shimniok/avrcam/Electronics/BOM.ods

 |  | Notes |  |  | Notes
C1 | 0.1uF |  | R1 | 10K
C2 | 0.1uF | ?? | R2 | 1K
C3 | 0.1uF | ?? | R3 | 1K
C4 | 0.1uF |  | R4 | 1K
C5 | 10uF |  | R5 | 10K
C6 | 0.1uF |  | R6 | 10K
C7 | 1uF | opt | R7 | 10K
C8 | 1uF | opt | R8 | 10K
C9 |  |  | R9 | 10K
C10 | 0.1uF
C11 |  |  | JP1
C12 |  |  | JP2 | 0.1 pin hd | opt
C13 | 1uF | opt | JP3
C14 |  |  | JP4
C15 | 1uF | opt
C16 |  |  | T1 | 2N3904
C17
C18
IC1 | Atmega8-P
IC2 | Attiny12
IC3
IC4
IC5 | LM2937
