shimniok/avrcam/(list of files, cad)

Other CAD files:
Tiny13/AVRCamTiny.obj
