shimniok/avrcam/Electronics/AVRcam.pdf

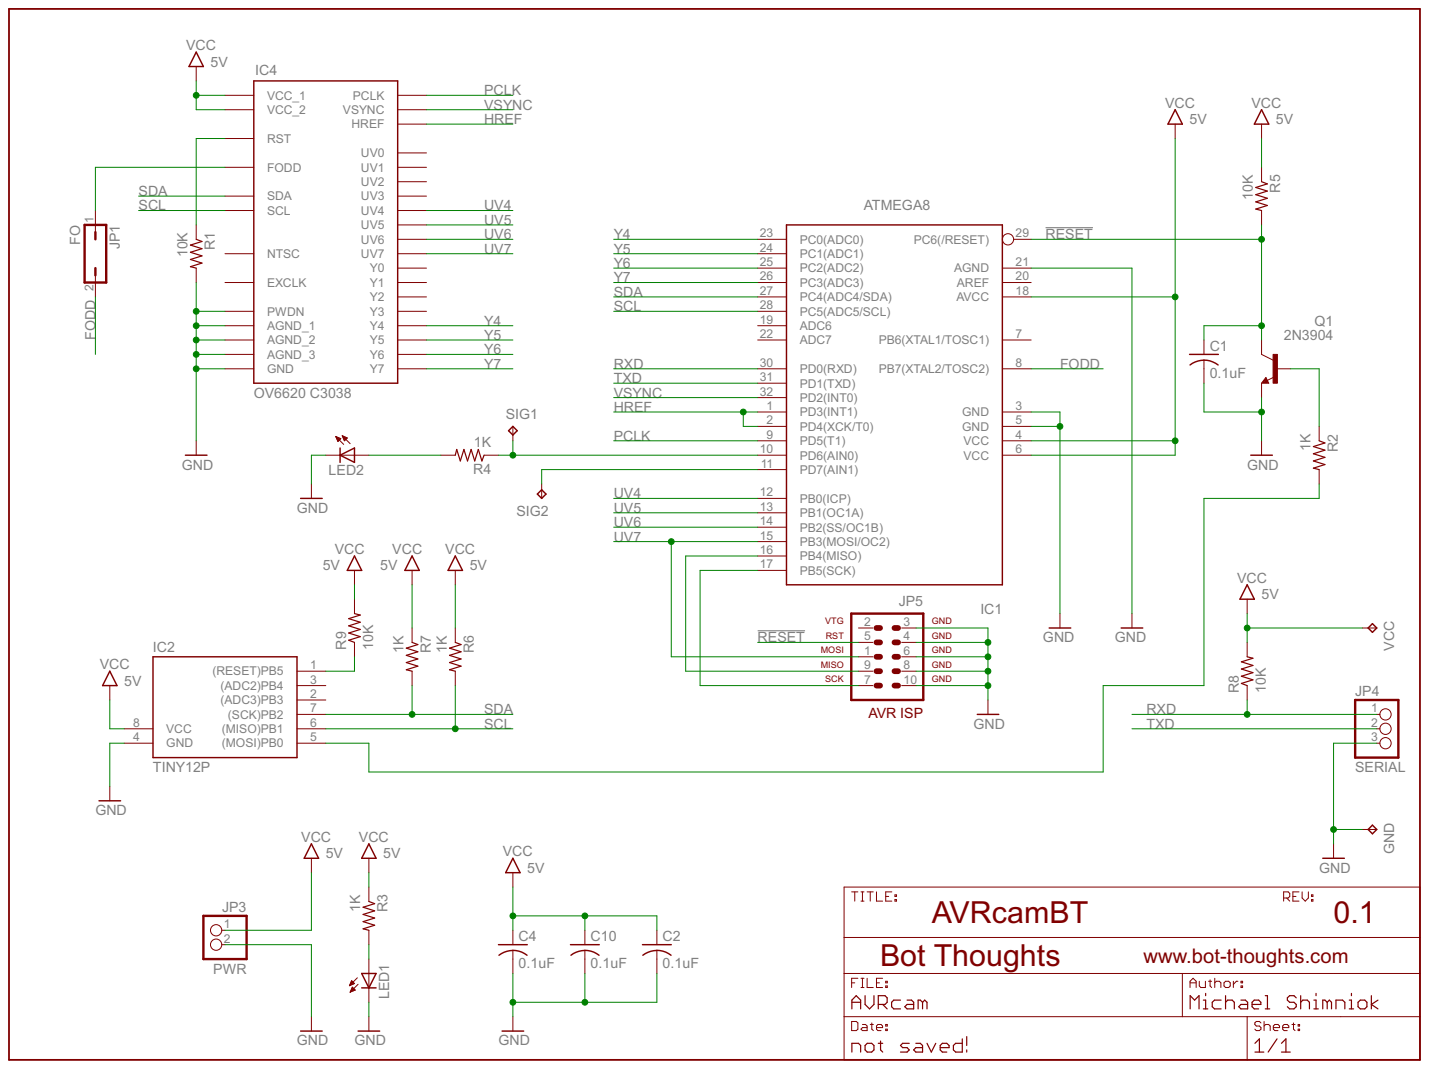
[picture p1: page 1]
