shimniok/avrcam/Electronics/AVRcam_sch.pdf

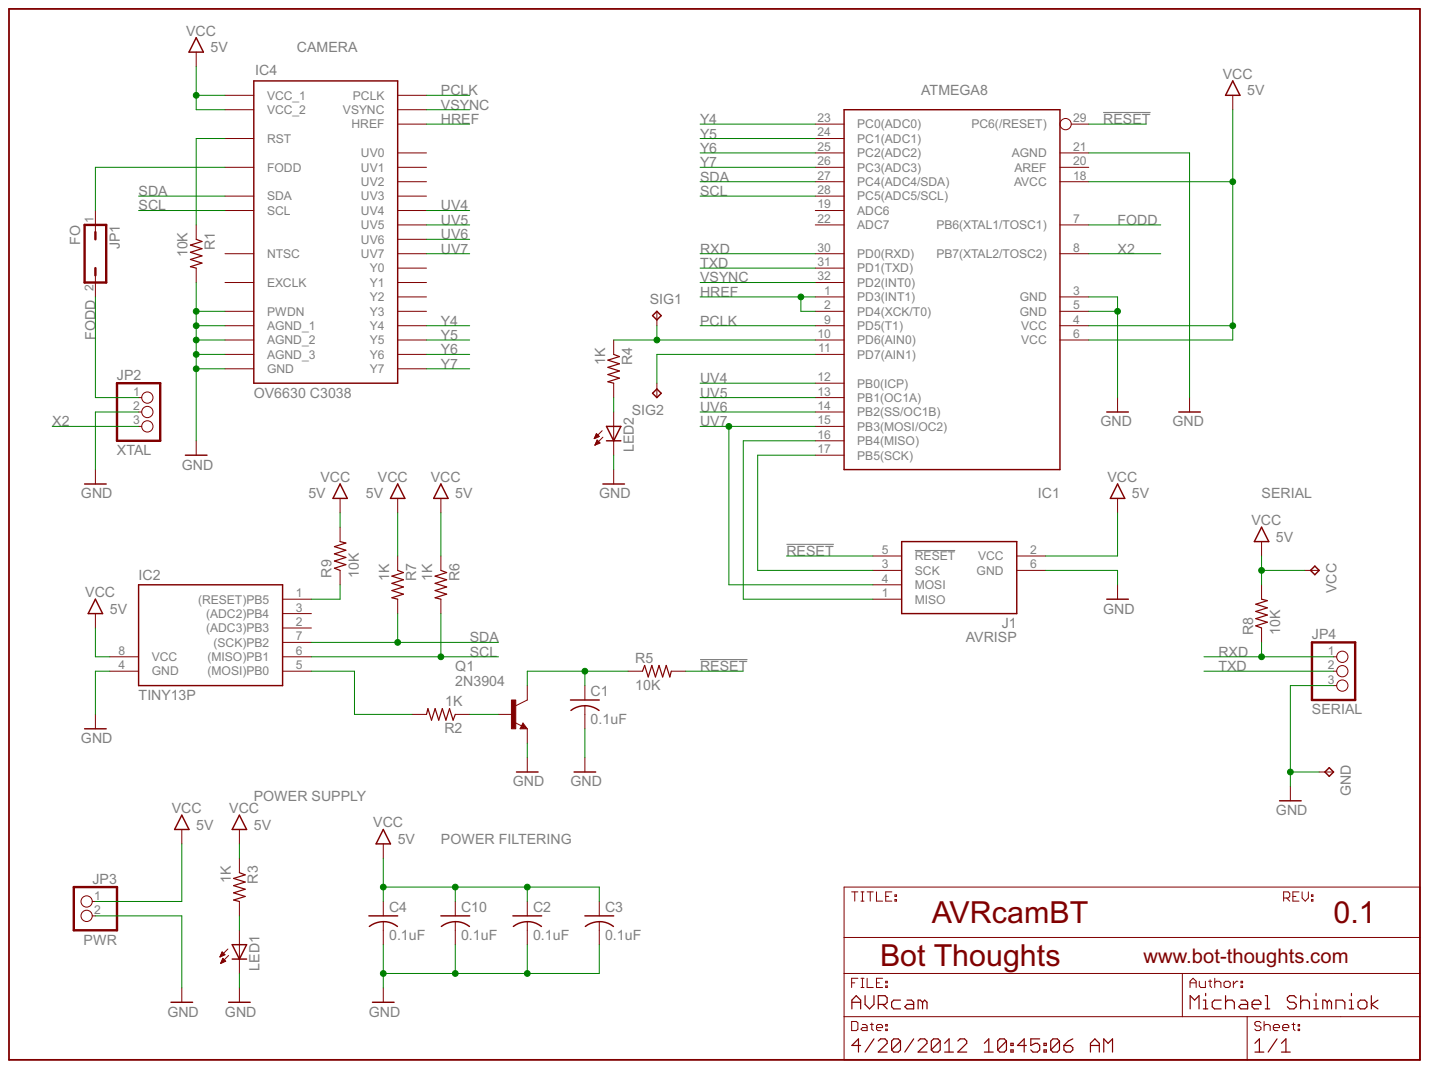
[picture p2: page 1]
