shimniok/avrcam/Electronics/AVRcam.brd

## EAGLE design Electronics/AVRcam.brd (2012-05-16)

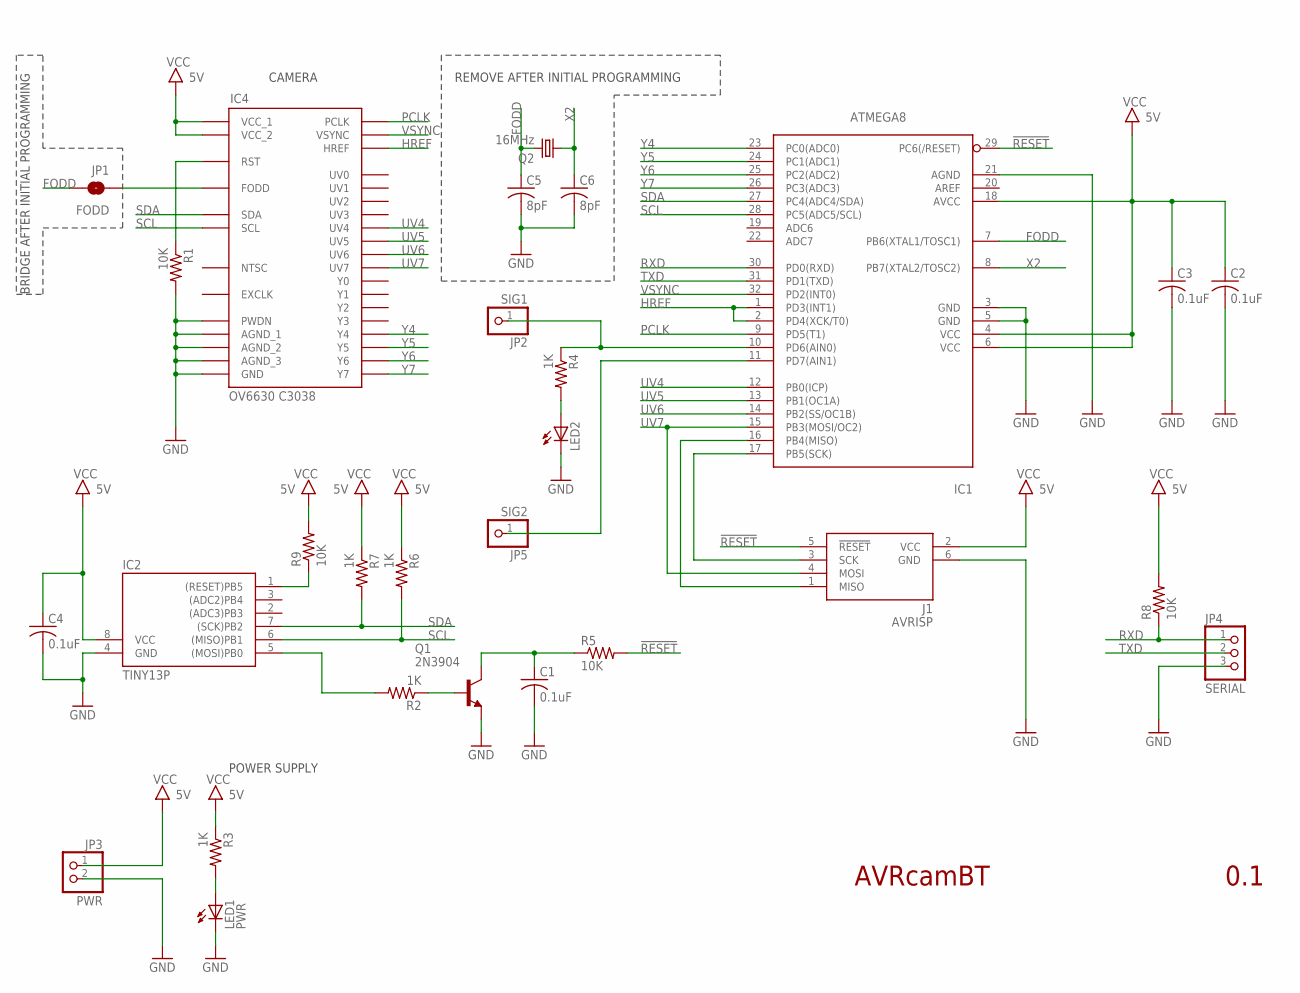
[picture p3: schematic AVRcam.sch]

Parts:
C1, C2, C3, C4: 0.1uF; C0603; PARTNO CC0603ZRY5V9BB104
C5, C6: 8pF; C0603; PARTNO C1608C0G1H080D
IC1: ATMEGA8; TQFP32-08; PARTNO ATMEGA8A-AU
IC2: TINY13P; DIL08; PARTNO ATTINY13V-10PU
IC4: OV6630 C3038; C3038/C3X88/C3088
J1: AVRISP; CON6P2R
JP1: FODD; SJ_2S-NO
JP2: SIG1; 1X01
JP3: PWR; 1X02-S
JP4: SERIAL; 1X03-S
JP5: SIG2; 1X01
LED1: PWR; CHIP-LED0805; PARTNO APT2012EC
LED2: LEDCHIP-LED0805; CHIP-LED0805; PARTNO APT2012SGC
Q1: 2N3904; SOT-23; PARTNO MMBT3904-7-F
Q2: 16MHz; NDK_2PAD_5X3; PARTNO NX5032GA-16.000000MHZ-LN-CD-1
R1, R5, R8, R9: 10K; R0603; PARTNO ERJ-3GEYJ103V
R2, R3, R4, R6, R7: 1K; R0603; PARTNO ERJ-3GEYJ102V

Connections:
!RESET: IC1.29 (PC6(/RESET)), J1.5 (!RESET), R5.2
FODD: C5.1, IC1.7 (PB6(XTAL1/TOSC1)), JP1.2, Q2.P$2 (2)
GND: C1.2, C2.2, C3.2, C4.2, C5.2, C6.2, IC1.3 (GND), IC1.5 (GND), IC1.21 (AGND), IC2.4 (GND), IC4.P$9 (PWDN), IC4.P$15 (AGND_1), IC4.P$17 (AGND_2), IC4.P$21 (AGND_3), IC4.P$31 (GND), J1.6 (GND), JP3.2, JP4.3, LED1.C, LED2.C, Q1.2 (E), R1.2
HREF: IC1.1 (PD3(INT1)), IC1.2 (PD4(XCK/T0)), IC4.P$14 (HREF)
MISO: IC1.16 (PB4(MISO)), J1.1 (MISO)
unnamed: C1.1, Q1.1 (C), R5.1
unnamed: IC1.11 (PD7(AIN1)), JP5.1
unnamed: LED2.A, R4.2
unnamed: IC1.10 (PD6(AIN0)), JP2.1, R4.1
unnamed: IC1.17 (PB5(SCK)), J1.3 (SCK)
unnamed: Q1.3 (B), R2.1
unnamed: LED1.A, R3.2
unnamed: IC4.P$10 (RST), R1.1
unnamed: IC4.P$12 (FODD), JP1.1
unnamed: IC2.5 ((MOSI)PB0), R2.2
unnamed: IC2.1 ((RESET)PB5), R9.1
PCLK: IC1.9 (PD5(T1)), IC4.P$18 (PCLK)
RXD: IC1.30 (PD0(RXD)), JP4.1, R8.1
SCL: IC1.28 (PC5(ADC5/SCL)), IC2.6 ((MISO)PB1), IC4.P$13 (SCL), R6.2
SDA: IC1.27 (PC4(ADC4/SDA)), IC2.7 ((SCK)PB2), IC4.P$11 (SDA), R7.2
TXD: IC1.31 (PD1(TXD)), JP4.2
UV4: IC1.12 (PB0(ICP)), IC4.P$27 (UV4)
UV5: IC1.13 (PB1(OC1A)), IC4.P$28 (UV5)
UV6: IC1.14 (PB2(SS/OC1B)), IC4.P$29 (UV6)
UV7: IC1.15 (PB3(MOSI/OC2)), IC4.P$30 (UV7), J1.4 (MOSI)
VCC: C2.1, C3.1, C4.1, IC1.4 (VCC), IC1.6 (VCC), IC1.18 (AVCC), IC2.8 (VCC), IC4.P$20 (VCC_1), IC4.P$22 (VCC_2), J1.2 (VCC), JP3.1, R3.1, R6.1, R7.1, R8.2, R9.2
VSYNC: IC1.32 (PD2(INT0)), IC4.P$16 (VSYNC)
X2: C6.1, IC1.8 (PB7(XTAL2/TOSC2)), Q2.P$1 (1)
Y4: IC1.23 (PC0(ADC0)), IC4.P$5 (Y4)
Y5: IC1.24 (PC1(ADC1)), IC4.P$6 (Y5)
Y6: IC1.25 (PC2(ADC2)), IC4.P$7 (Y6)
Y7: IC1.26 (PC3(ADC3)), IC4.P$8 (Y7)

Notes on the sheet:
AVRcamBT
0.1
POWER SUPPLY
CAMERA
REMOVE AFTER INITIAL PROGRAMMING
BRIDGE AFTER INITIAL PROGRAMMING

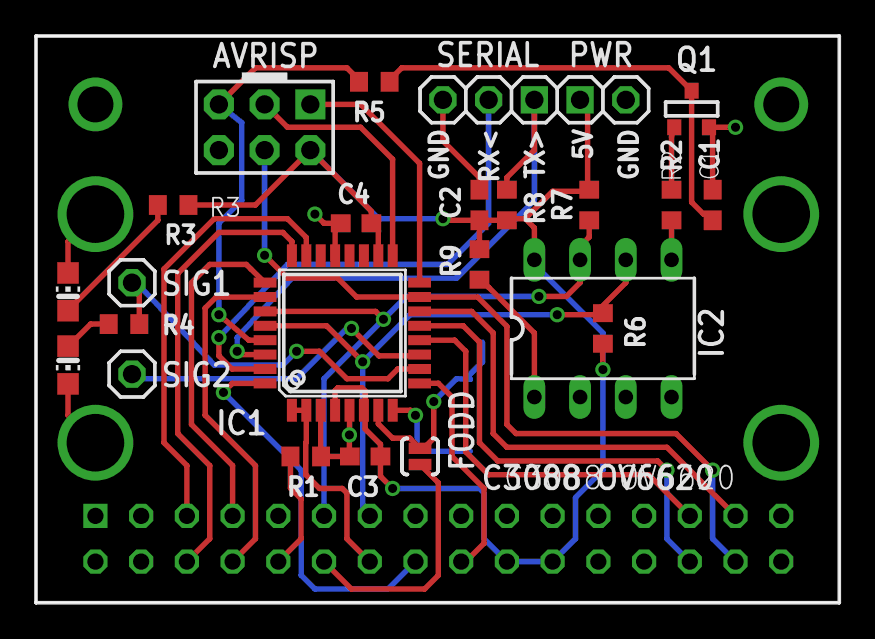
[picture p4: board AVRcam.brd from above]

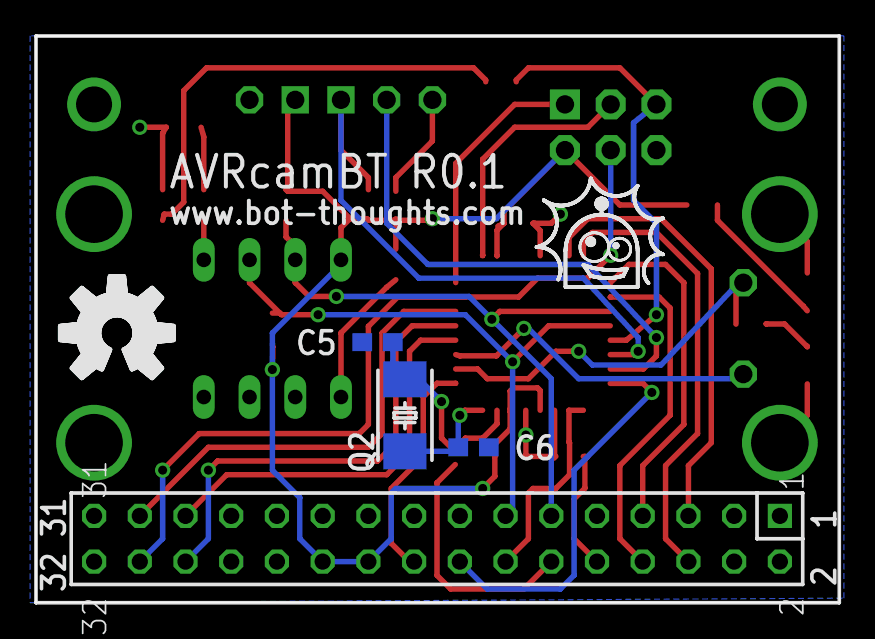
[picture p5: board AVRcam.brd from below]

Board: 2 copper layers, 44.6 x 31.5 mm, 28 parts (4 on the bottom side), 32 nets.
